victor-lvsy/FLUTE_ALORGUE/flûte à l'orgue.pptx

## Flûte à l'Orgue

Guzzo Marco
Levesy Victor
Boisserie Charles

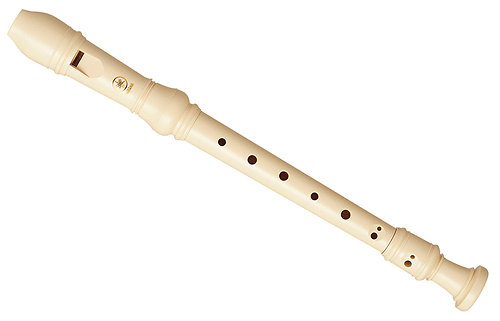
[picture p1: figure]

## Concept :

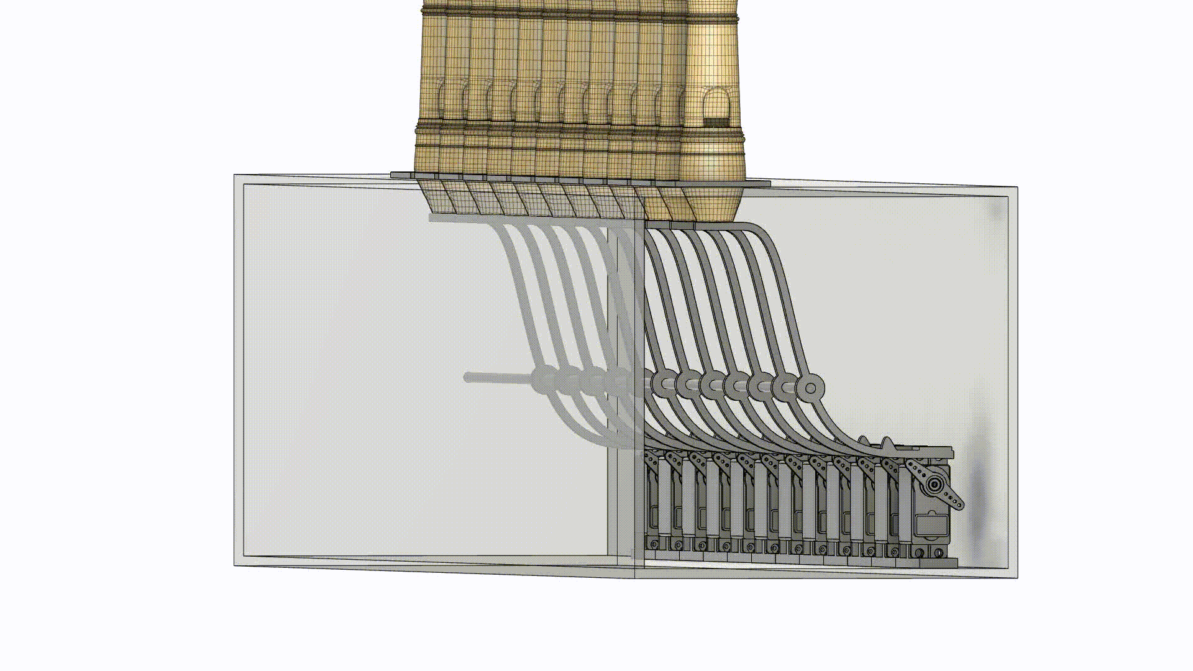
[picture p2: figure]

Un carton est utilisé comme réserve d'air, alimentée par une turbine.
L'ouverture des flûtes est commandée mécaniquement depuis les servomoteurs

## Partie Electronique :

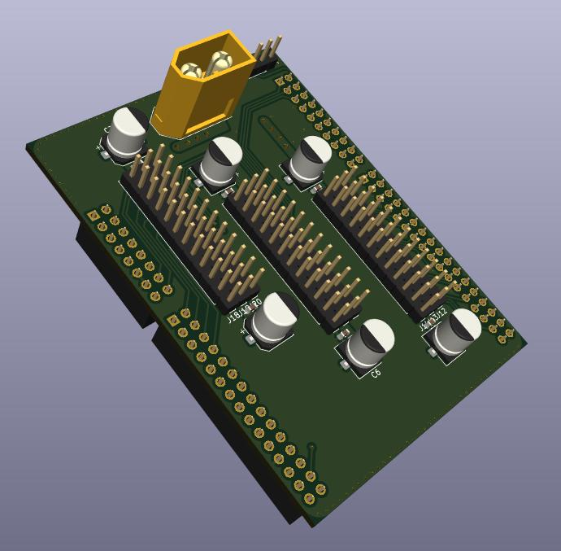
[picture p3: figure]

Réalisation d'un PCB reliant les servomoteurs et la turbine à la carte utilisée (H7) et les alimentant.

## Partie Informatique

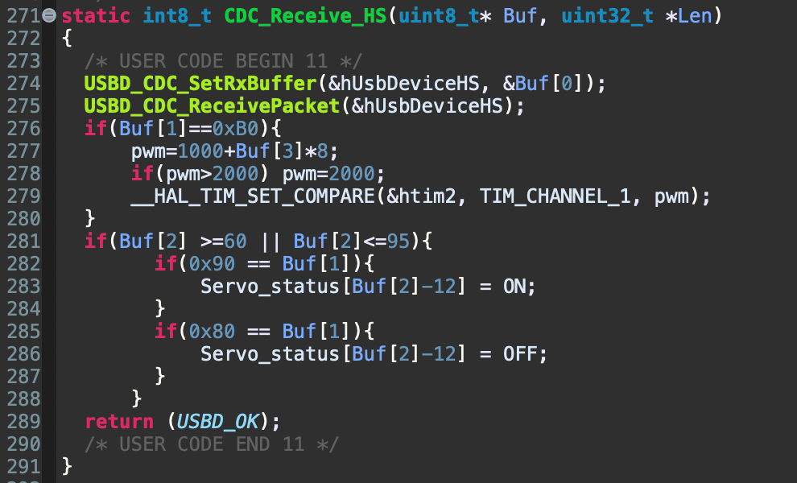
[picture p4: figure]

Code réalisé sur STM32CubeIDE permettant d'importer des commandes claviers via Renoise et de distribuer les commandes correspondantes vers les servomoteurs

## Merci !
