victor-lvsy/FLUTE_ALORGUE/3DModel/Support flt x11.stl

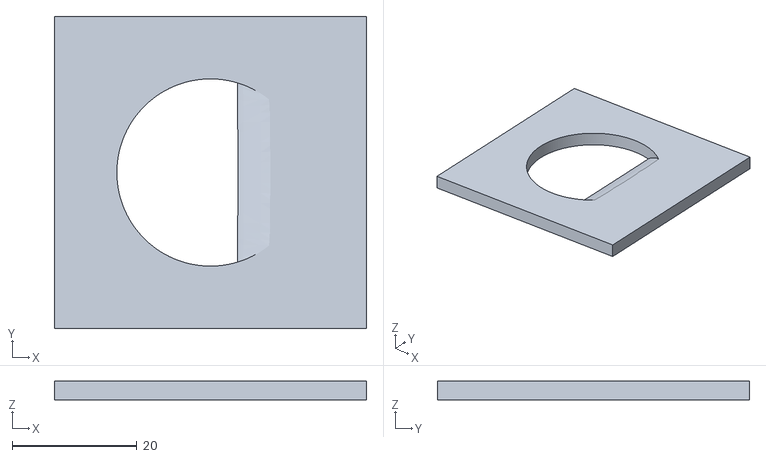
[picture p5: CAD file, 2023-05-11]
3DModel/Support flt x11.stl
50.0 x 50.0 x 3.00
