victor-lvsy/FLUTE_ALORGUE/3DModel/Axe x11.stl

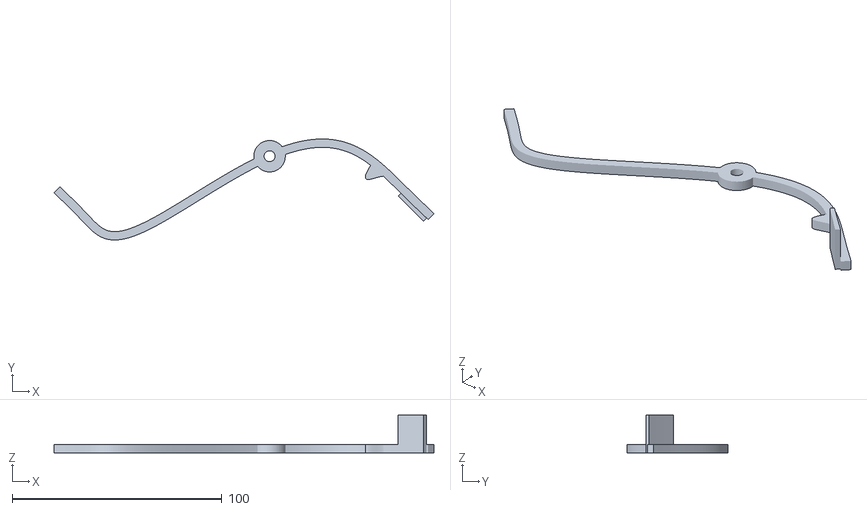
[picture p6: CAD file, 2023-05-11]
3DModel/Axe x11.stl
181.0 x 48.1 x 18.0
