victor-lvsy/FLUTE_ALORGUE/3DModel/Supports moteur x11.stl

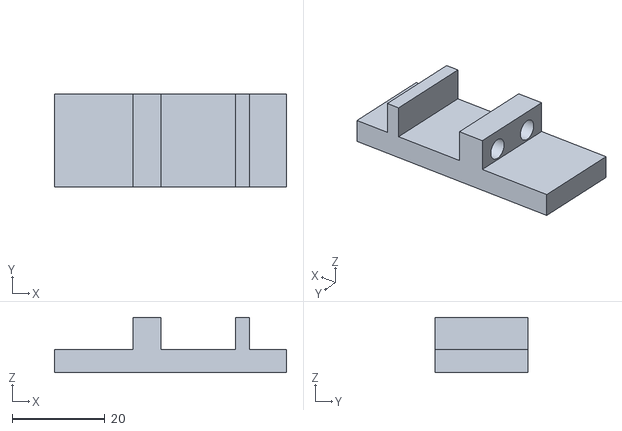
[picture p7: CAD file, 2023-05-11]
3DModel/Supports moteur x11.stl
50.0 x 20.0 x 11.9
