victor-lvsy/FLUTE_ALORGUE/PCB/FLUTEALORGUE.kicad_pcb

## KiCad design PCB/FLUTEALORGUE.kicad_pcb (2023-05-11)

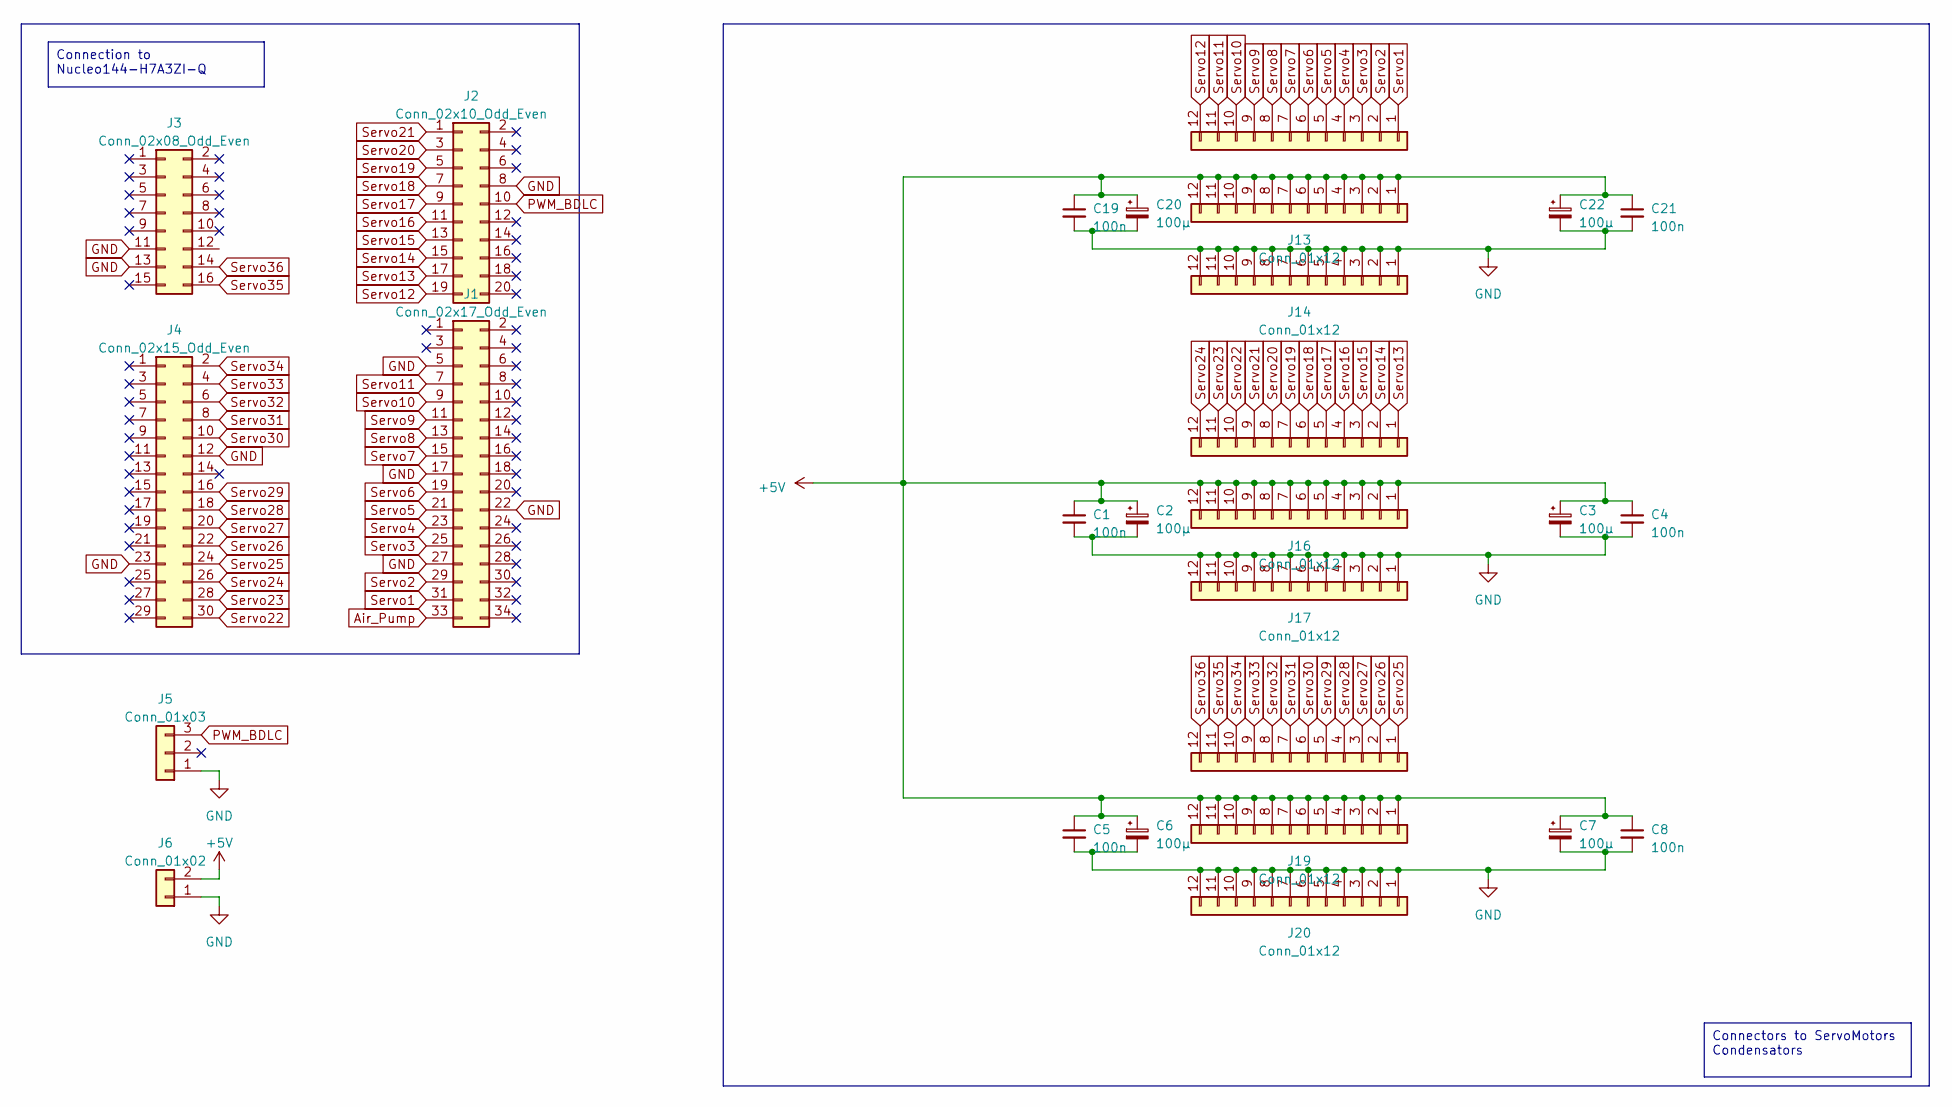
[picture p8: schematic FLUTEALORGUE.kicad_sch]

Parts:
C1, C4, C5, C8, C19, C21: 100n; C_0603_1608Metric_Pad1.08x0.95mm_HandSolder
C2, C3, C6, C7, C20, C22: 100µ; CP_Elec_6.3x7.7
J1: Conn_02x17_Odd_Even; PinSocket_2x17_P2.54mm_Vertical
J2: Conn_02x10_Odd_Even; PinSocket_2x10_P2.54mm_Vertical
J3: Conn_02x08_Odd_Even; PinSocket_2x08_P2.54mm_Vertical
J4: Conn_02x15_Odd_Even; PinSocket_2x15_P2.54mm_Vertical
J5: Conn_01x03; PinHeader_1x03_P2.54mm_Vertical
J6: Conn_01x02; AMASS_XT60-M_1x02_P7.20mm_Vertical
J12, J13, J14, J15, J16, J17, J18, J19, J20: Conn_01x12; PinHeader_1x12_P2.54mm_Vertical

Connections:
+5V: C1.1, C2.1, C3.1, C4.1, C5.1, C6.1, C7.1, C8.1, C19.1, C20.1, C21.1, C22.1, J6.2, J13.1, J13.2, J13.3, J13.4, J13.5, J13.6, J13.7, J13.8, J13.9, J13.10, J13.11, J13.12, J16.1, J16.2, J16.3, J16.4, J16.5, J16.6, J16.7, J16.8, J16.9, J16.10, J16.11, J16.12, J19.1, J19.2, J19.3, J19.4, J19.5, J19.6, J19.7, J19.8, J19.9, J19.10, J19.11, J19.12
Air_Pump: J1.33
GND: C1.2, C2.2, C3.2, C4.2, C5.2, C6.2, C7.2, C8.2, C19.2, C20.2, C21.2, C22.2, J1.5, J1.17, J1.22, J1.27, J2.8, J3.11, J3.13, J4.12, J4.23, J5.1, J6.1, J14.1, J14.2, J14.3, J14.4, J14.5, J14.6, J14.7, J14.8, J14.9, J14.10, J14.11, J14.12, J17.1, J17.2, J17.3, J17.4, J17.5, J17.6, J17.7, J17.8, J17.9, J17.10, J17.11, J17.12, J20.1, J20.2, J20.3, J20.4, J20.5, J20.6, J20.7, J20.8, J20.9, J20.10, J20.11, J20.12
PWM_BDLC: J2.10, J5.3
Servo1: J1.31, J12.1
Servo2: J1.29, J12.2
Servo3: J1.25, J12.3
Servo4: J1.23, J12.4
Servo5: J1.21, J12.5
Servo6: J1.19, J12.6
Servo7: J1.15, J12.7
Servo8: J1.13, J12.8
Servo9: J1.11, J12.9
Servo10: J1.9, J12.10
Servo11: J1.7, J12.11
Servo12: J2.19, J12.12
Servo13: J2.17, J15.1
Servo14: J2.15, J15.2
Servo15: J2.13, J15.3
Servo16: J2.11, J15.4
Servo17: J2.9, J15.5
Servo18: J2.7, J15.6
Servo19: J2.5, J15.7
Servo20: J2.3, J15.8
Servo21: J2.1, J15.9
Servo22: J4.30, J15.10
Servo23: J4.28, J15.11
Servo24: J4.26, J15.12
Servo25: J4.24, J18.1
Servo26: J4.22, J18.2
Servo27: J4.20, J18.3
Servo28: J4.18, J18.4
Servo29: J4.16, J18.5
Servo30: J4.10, J18.6
Servo31: J4.8, J18.7
Servo32: J4.6, J18.8
Servo33: J4.4, J18.9
Servo34: J4.2, J18.10
Servo35: J3.16, J18.11
Servo36: J3.14, J18.12

Notes on the sheet:
Connection to Nucleo144-H7A3ZI-Q
Connectors to ServoMotors Condensators

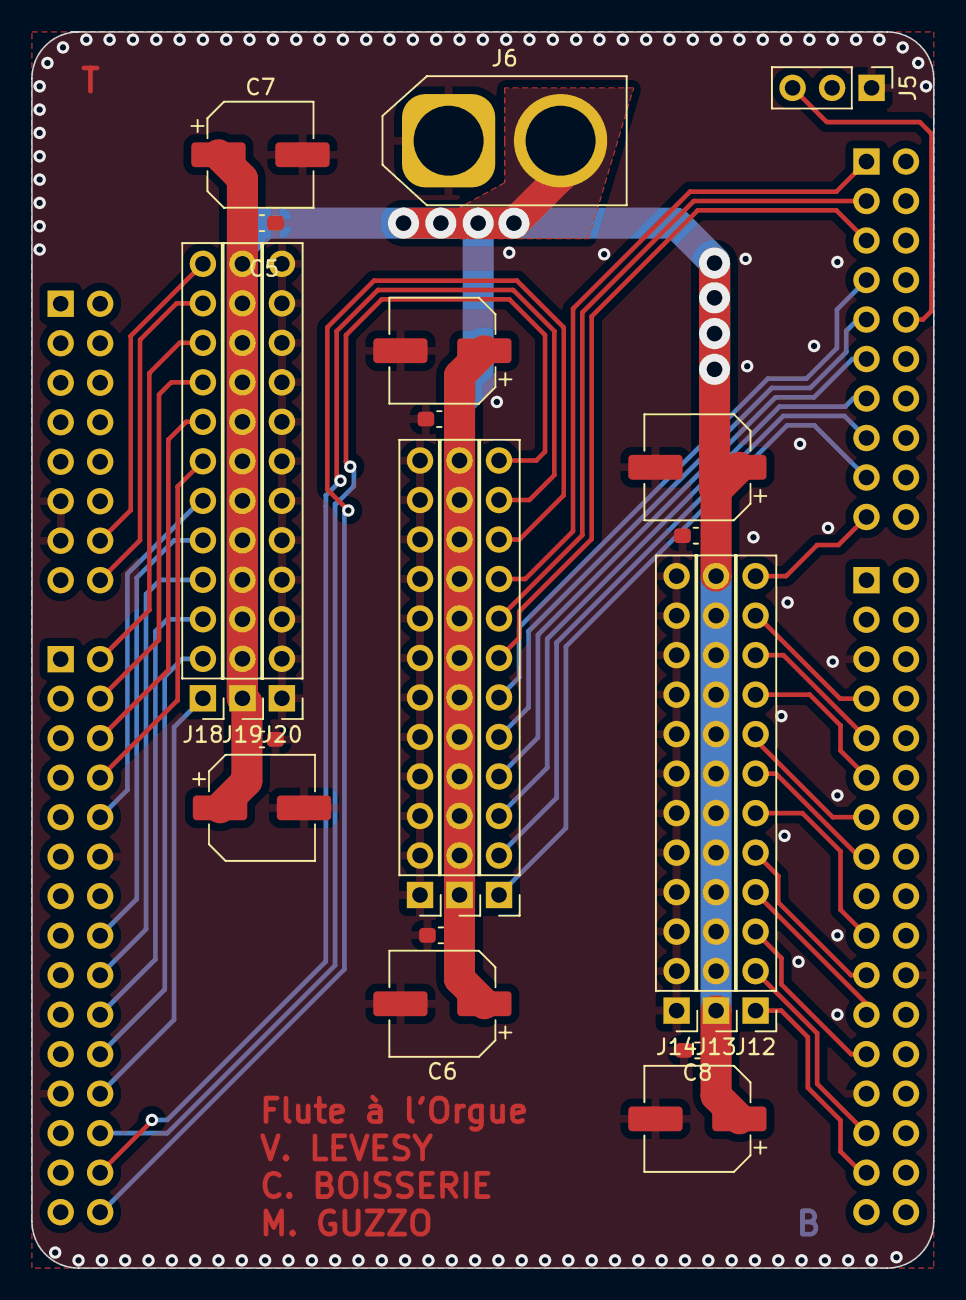
[picture p9: board FLUTEALORGUE.kicad_pcb from above]

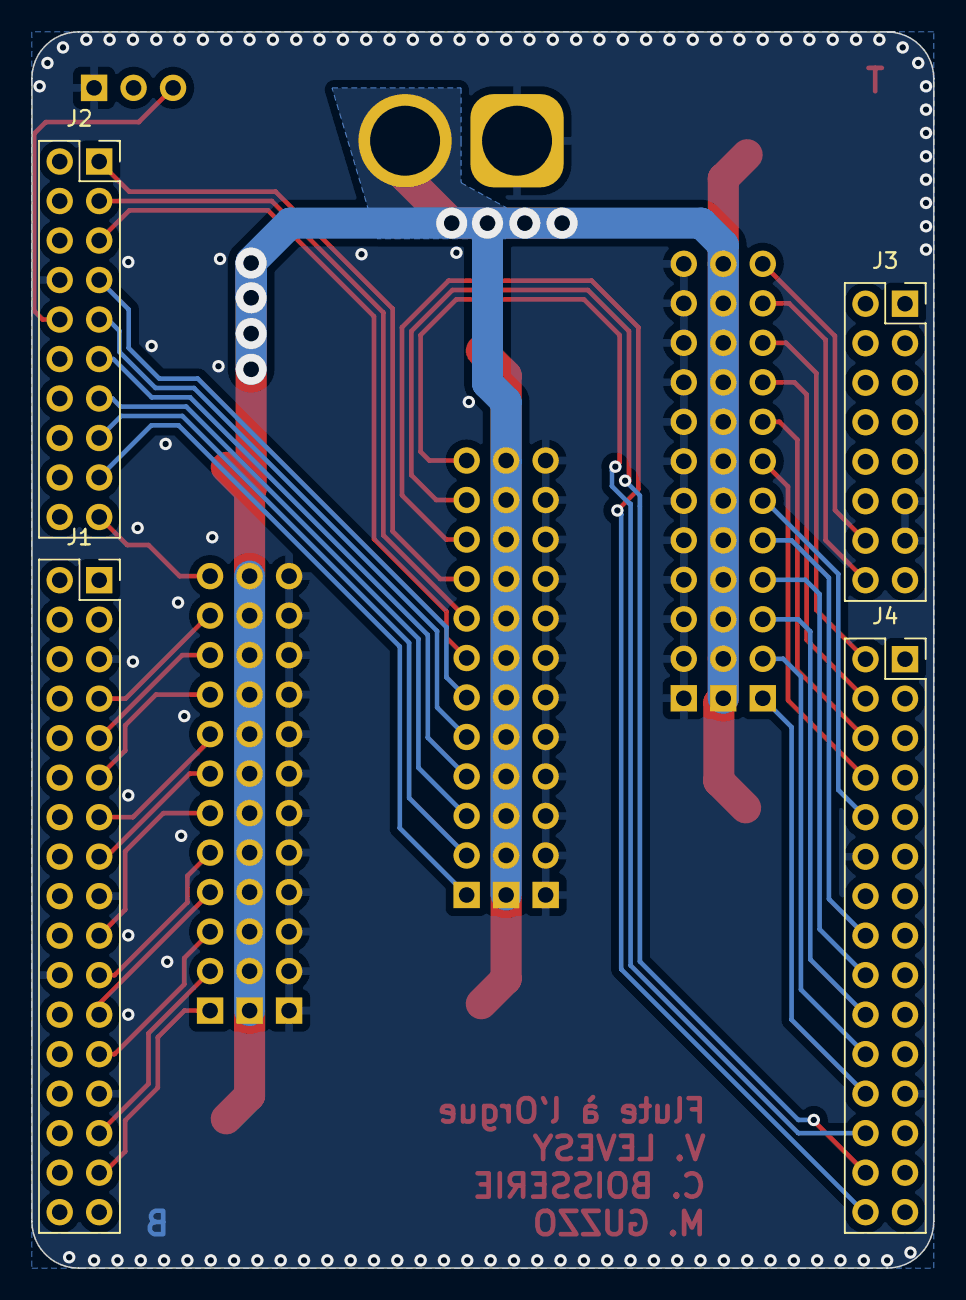
[picture p10: board FLUTEALORGUE.kicad_pcb from below]

Board: 2 copper layers, 58.0 x 79.5 mm, 27 parts (4 on the bottom side), 39 nets.
