victor-lvsy/FLUTE_ALORGUE/FLUTE_ALORGUE/Core/Inc/main.h

#define Servo3_Pin GPIO_PIN_2
#define Servo3_GPIO_Port GPIOE
#define Servo26_Pin GPIO_PIN_3
#define Servo26_GPIO_Port GPIOE
#define Servo29_Pin GPIO_PIN_4
#define Servo29_GPIO_Port GPIOE
#define Servo28_Pin GPIO_PIN_5
#define Servo28_GPIO_Port GPIOE
#define Servo27_Pin GPIO_PIN_6
#define Servo27_GPIO_Port GPIOE
#define B1_Pin GPIO_PIN_13
#define B1_GPIO_Port GPIOC
#define OSC32_IN_Pin GPIO_PIN_14
#define OSC32_IN_GPIO_Port GPIOC
#define OSC32_OUT_Pin GPIO_PIN_15
#define OSC32_OUT_GPIO_Port GPIOC
#define Servo24_Pin GPIO_PIN_7
#define Servo24_GPIO_Port GPIOF
#define Servo25_Pin GPIO_PIN_8
#define Servo25_GPIO_Port GPIOF
#define Servo23_Pin GPIO_PIN_9
#define Servo23_GPIO_Port GPIOF
#define USB_FS_PWR_EN_Pin GPIO_PIN_10
#define USB_FS_PWR_EN_GPIO_Port GPIOF
#define PH0_MCU_Pin GPIO_PIN_0
#define PH0_MCU_GPIO_Port GPIOH
#define PH1_MCU_Pin GPIO_PIN_1
#define PH1_MCU_GPIO_Port GPIOH
#define Servo11_Pin GPIO_PIN_1
#define Servo11_GPIO_Port GPIOC
#define Servo2_Pin GPIO_PIN_0
#define Servo2_GPIO_Port GPIOA
#define Servo9_Pin GPIO_PIN_2
#define Servo9_GPIO_Port GPIOA
#define Servo13_Pin GPIO_PIN_4
#define Servo13_GPIO_Port GPIOA
#define Servo10_Pin GPIO_PIN_5
#define Servo10_GPIO_Port GPIOC
#define Servo1_Pin GPIO_PIN_0
#define Servo1_GPIO_Port GPIOB
#define Servo7_Pin GPIO_PIN_2
#define Servo7_GPIO_Port GPIOB
#define Servo18_Pin GPIO_PIN_12
#define Servo18_GPIO_Port GPIOB
#define Servo19_Pin GPIO_PIN_13
#define Servo19_GPIO_Port GPIOB
#define LD3_Pin GPIO_PIN_14
#define LD3_GPIO_Port GPIOB
#define Servo20_Pin GPIO_PIN_15
#define Servo20_GPIO_Port GPIOB
#define STLINK_RX_Pin GPIO_PIN_8
#define STLINK_RX_GPIO_Port GPIOD
#define STLINK_TX_Pin GPIO_PIN_9
#define STLINK_TX_GPIO_Port GPIOD
#define Servo22_Pin GPIO_PIN_10
#define Servo22_GPIO_Port GPIOD
#define Servo4_Pin GPIO_PIN_11
#define Servo4_GPIO_Port GPIOD
#define Servo5_Pin GPIO_PIN_12
#define Servo5_GPIO_Port GPIOD
#define Servo6_Pin GPIO_PIN_13
#define Servo6_GPIO_Port GPIOD
#define Servo8_Pin GPIO_PIN_6
#define Servo8_GPIO_Port GPIOG
#define USB_FS_OVCR_Pin GPIO_PIN_7
#define USB_FS_OVCR_GPIO_Port GPIOG
#define Servo35_Pin GPIO_PIN_8
#define Servo35_GPIO_Port GPIOG
#define Servo21_Pin GPIO_PIN_6
#define Servo21_GPIO_Port GPIOC
#define Servo16_Pin GPIO_PIN_7
#define Servo16_GPIO_Port GPIOC
#define USB_FS_VBUS_Pin GPIO_PIN_9
#define USB_FS_VBUS_GPIO_Port GPIOA
#define USB_FS_ID_Pin GPIO_PIN_10
#define USB_FS_ID_GPIO_Port GPIOA
#define USB_FS_N_Pin GPIO_PIN_11
#define USB_FS_N_GPIO_Port GPIOA
#define USB_FS_P_Pin GPIO_PIN_12
#define USB_FS_P_GPIO_Port GPIOA
#define Servo17_Pin GPIO_PIN_15
#define Servo17_GPIO_Port GPIOA
#define Servo30_Pin GPIO_PIN_3
#define Servo30_GPIO_Port GPIOD
#define Servo31_Pin GPIO_PIN_4
#define Servo31_GPIO_Port GPIOD
#define Servo32_Pin GPIO_PIN_5
#define Servo32_GPIO_Port GPIOD
#define Servo33_Pin GPIO_PIN_6
#define Servo33_GPIO_Port GPIOD
#define Servo34_Pin GPIO_PIN_7
#define Servo34_GPIO_Port GPIOD
#define Servo36_Pin GPIO_PIN_10
#define Servo36_GPIO_Port GPIOG
#define Servo14_Pin GPIO_PIN_3
#define Servo14_GPIO_Port GPIOB
#define Servo12_Pin GPIO_PIN_4
#define Servo12_GPIO_Port GPIOB
#define Servo15_Pin GPIO_PIN_5
#define Servo15_GPIO_Port GPIOB
#define LD2_Pin GPIO_PIN_1
#define LD2_GPIO_Port GPIOE
